nandini-ag08/Project-X--Line-maze-solver-tasks/BOM/Power block diagram.jpg

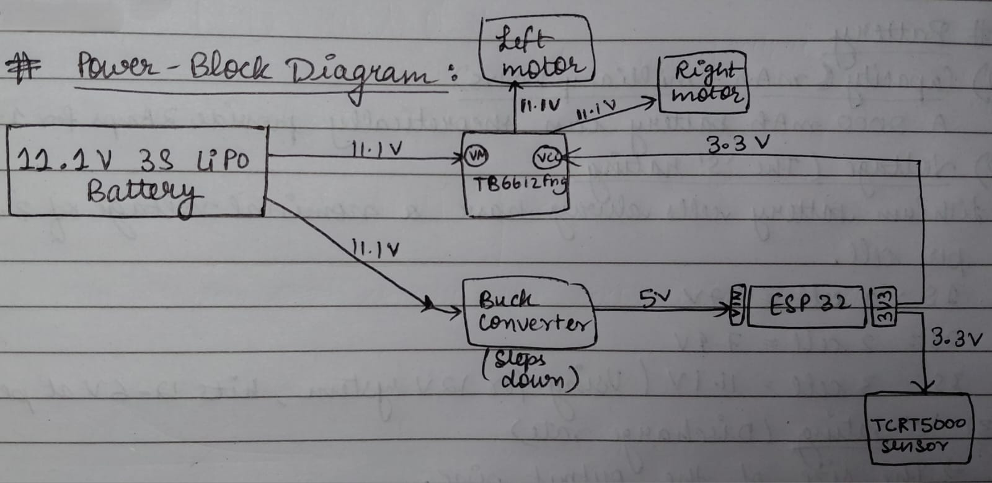
BOM/Power block diagram.jpg
