nandini-ag08/Project-X--Line-maze-solver-tasks/BOM/Task-7 Data flow.jpeg

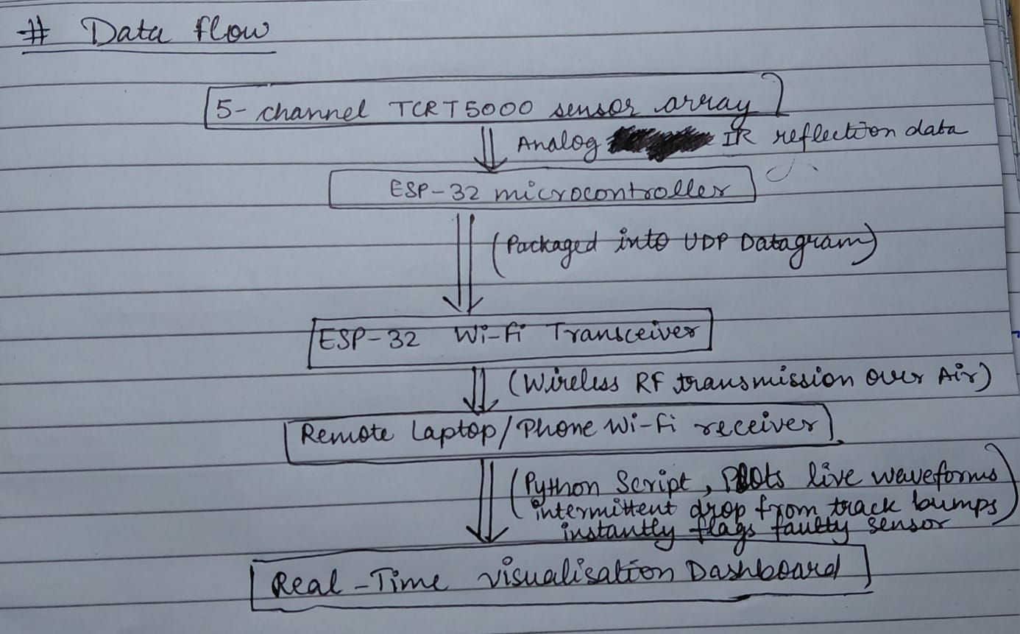
BOM/Task-7 Data flow.jpeg
