nandini-ag08/Project-X--Line-maze-solver-tasks/BOM/BOM.csv

Component | Exact Model | Qty | Unit Price | Total Price | Key Specifications & Rationale | Supplier Link (Example)
Microcontroller | ESP32-WROOM-32 Dev Kit V1 | 1 | ₹434 | ₹434 | Specs: Dual-core 240MHz, 3.3V logic. Rationale: Processing speed needed for fast PID loop calculations over the line array. | https://robu.in/product/esp-wroom-32-wifi-bluetooth-networking-smart-component-development-board/
Battery | Orange PRO-RANGE 850mAh 3S 30C | 1 | ₹1159 | ₹1159 | Specs: 11.1V nominal, 75g weight, 30C continuous. Rationale: Ultra-lightweight mass prevents corner skidding; 30C rating prevents ESP32 brownouts. | https://robu.in/product/orange-850mah-3s-30c-60c-lithium-polymer-battery-pack-lipo/
Motors | GA12-N20 Micro Metal Gearmotor | 2 | ₹229 | ₹458 | Specs: 600 RPM @ 12V, 0.75A stall current, 12g. Rationale: Extremely high top-speed for straightaways, minimal weight penalty. | https://robu.in/product/n20-12v-600-rpm-micro-metal-gear-motor/
Motor Driver | TB6612FNG Dual Channel | 1 | ₹150 | ₹150 | Specs: 1.2A continuous (3.2A peak) per channel, MOSFET-based. Rationale: Highly efficient with low voltage drop, tiny footprint. | https://robu.in/product/motor-driver-tb6612fng-module-performance-ultra-small-volume-3-pi-matching-performance-ultra-l298n/
Line Sensor | 5-Channel TCRT5000 Array | 1 | ₹209 | ₹209 | Specs: 5 IR pairs, analog/digital out, 3.3V-5V logic. Rationale: Wide array provides high-resolution positional data for precise PID line-following. | https://robu.in/product/tcrt5000l-5-channel-tracking-sensor-tracking-module-infrared-sensor/
Voltage Regulator | MP1584EN Mini Buck Converter | 1 | ₹105 | ₹105 | Specs: 3A max, steps 11.1V down to 5V. Rationale: Powers the ESP32 via VIN pin safely without overheating the onboard linear regulator. | https://robu.in/product/mini-mp1584-dc-dc-adjustable-buck-module-3a/
Wheels | N20 Micro D-Shaft Rubber Wheels | 2 | ₹59 | ₹118 | Specs: 34mm diameter, high-friction silicone. Rationale: Low center of gravity and excellent grip on competition track surfaces. | https://robu.in/product/34mm-mini-car-n20-motor-wheel-rubber-small-wheel/
Jumpers | M2M, M2F, F2F | 1 | ₹145 | ₹145 | - | https://robu.in/product/10-cm-40-pin-dupont-male-male-male-female-female-female-cable-combo/
Ball Caster | - | 1 | ₹59 | ₹59 | Mounting Hole PCD (mm) -38mm, Ball diameter- 5/8 inch , load capacity- 10kg | https://robu.in/product/wheel-of-metal/
Slide switch | Slide Switch SS-12D00 1P2T | 1 | ₹1.89 | ₹1.89 | - | https://robu.in/product/1-month-warranty-255/
Connector | T-Connector (Deans) Male Pigtail | 1 | ₹131 | ₹131 | Specs: Rated for high current. Rationale: Safely interfaces the 3S LiPo to the buck converter and motor driver VMOT. | https://robu.in/product/male-t-connector-female-xt-60-1pcbag/
Shipping | Standard Courier Shipping | 1 | ₹200 | ₹200 | Allocation for component delivery fees. | N/A
Contingency | Spares (Extra N20 motor, TB6612FNG) | 1 | ₹1000 | ₹1000 | Competition failsafe budget. | N/A
TOTAL |  |  |  | ₹4169.89 | Well within the ₹10,000 maximum budget limit.
