nandini-ag08/Project-X--Line-maze-solver-tasks/BOM/Task-8 example maze diagram.jpeg

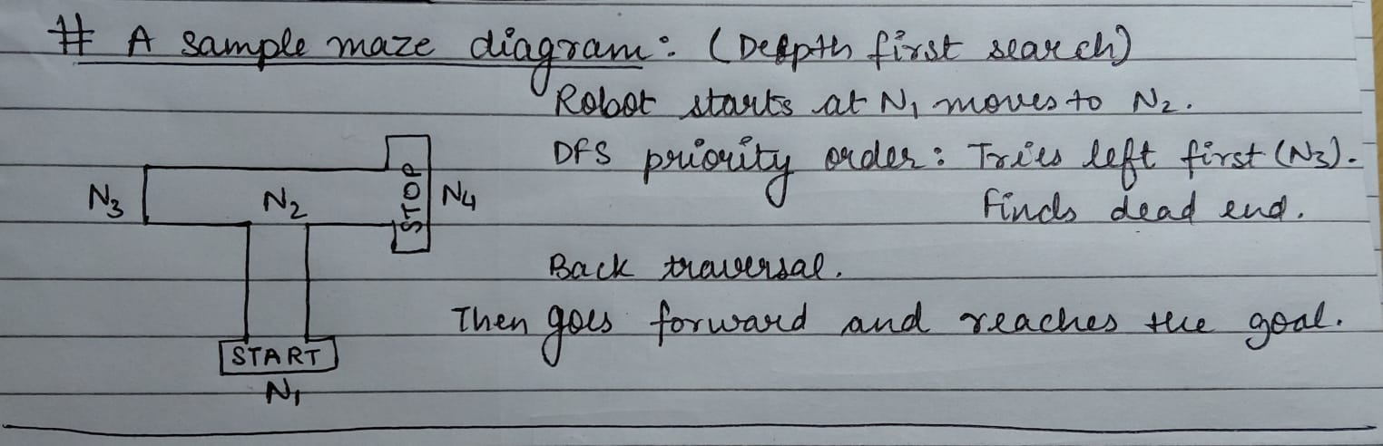
BOM/Task-8 example maze diagram.jpeg
