nandini-ag08/Project-X--Line-maze-solver-tasks/BOM/Wiring Diagram Task-6.jpeg

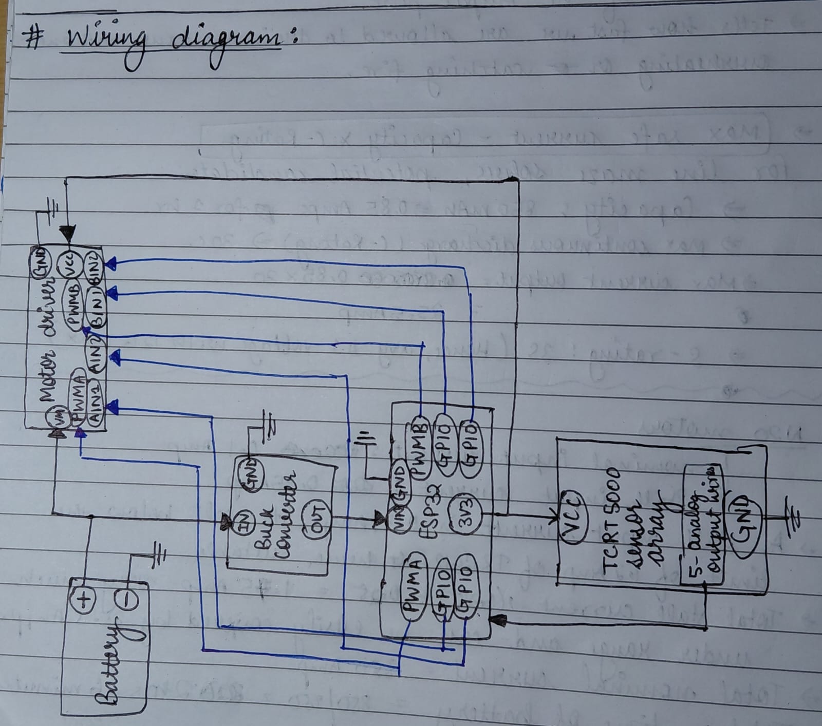
BOM/Wiring Diagram Task-6.jpeg
